karthikpp03/ai-desk-animation-cloud/firmware/AIDeskCompanion/MotionAnimations.h

#pragma once
#include <Arduino.h>

// Compressed 128x64 OLED motion animations generated from the supplied reference sketches.
// Each frame is byte-RLE encoded as [runLength, byteValue] pairs.
// The source frame data is preserved; compression keeps flash use low enough for ESP32 firmware.

static const uint16_t IDIOT_FRAME_COUNT = 50;
static const uint16_t IDIOT_FRAME_OFFSETS[51] PROGMEM = {
  0, 10, 48, 94, 136, 200, 266, 332, 398, 464, 530, 596,
  662, 728, 794, 860, 902, 946, 1004, 1066, 1152, 1234, 1350, 1462,
  1588, 1710, 1878, 2038, 2202, 2386, 2566, 2764, 2952, 3140, 3328, 3516,
  3704, 3892, 4080, 4268, 4456, 4644, 4832, 5020, 5208, 5396, 5584, 5772,
  5960, 6148, 6336
};
static const uint8_t IDIOT_RLE_DATA[6336] PROGMEM = {
  0xFF, 0x00, 0xFF, 0x00, 0xFF, 0x00, 0xFF, 0x00, 0x04, 0x00, 0xFF, 0x00, 0xC8, 0x00, 0x01, 0x03, 0x01, 0x80, 0x0E, 0x00, 0x01, 0x01, 0x0F, 0x00,
  0x01, 0x01, 0x0F, 0x00, 0x01, 0x01, 0x0F, 0x00, 0x01, 0x01, 0x0F, 0x00, 0x01, 0x01, 0x0F, 0x00, 0x01, 0x03, 0x01, 0x80, 0xFF, 0x00, 0xD8, 0x00,
  0xFF, 0x00, 0xC8, 0x00, 0x01, 0x1C, 0x01, 0x08, 0x0E, 0x00, 0x02, 0x08, 0x0E, 0x00, 0x01, 0x08, 0x01, 0x68, 0x0E, 0x00, 0x01, 0x08, 0x01, 0x98,
  0x0E, 0x00, 0x01, 0x08, 0x01, 0x88, 0x0E, 0x00, 0x01, 0x08, 0x01, 0x88, 0x0E, 0x00, 0x01, 0x1C, 0x01, 0x78, 0xFF, 0x00, 0xD8, 0x00, 0xFF, 0x00,
  0xC8, 0x00, 0x01, 0xE0, 0x01, 0x44, 0x0E, 0x00, 0x02, 0x40, 0x0E, 0x00, 0x01, 0x43, 0x01, 0x4C, 0x0E, 0x00, 0x01, 0x44, 0x01, 0xC4, 0x0E, 0x00,
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
  0x01, 0x20, 0x0A, 0x00, 0x01, 0x40, 0x01, 0x00, 0x01, 0x04, 0x02, 0x00, 0x01, 0x40, 0x0C, 0x00, 0x01, 0x04, 0x06, 0x00, 0x01, 0x04, 0x0F, 0x00,
  0x01, 0x03, 0x10, 0x00, 0x01, 0xC0, 0x68, 0x00, 0x01, 0x40, 0x0C, 0x00, 0x01, 0x04, 0x01, 0x00, 0x01, 0x01, 0x01, 0x80, 0x0C, 0x00, 0x01, 0x04,
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
};
