karthikpp03/ai-desk-animation-cloud/(commit log)

2026-10-04 Update device command state
2026-10-04 Add animation frames: alone
2026-10-04 Update device heartbeat
2026-10-04 Add animation frames: anime
2026-10-04 Request device mode change
2026-10-04 Add animation frames: alone2
2026-10-04 Add animation frames: back_hug
2026-10-04 Add animation frames: cat
2026-10-04 Add animation frames: cat_tap
2026-10-04 Add animation metadata: coupled
2026-10-04 Add animation frames: coupled
2026-10-04 Add animation frames: hand_hold
2026-10-04 Add animation frames: hug
2026-10-04 Add animation frames: love
2026-10-04 Add animation frames: music
2026-10-04 Add animation frames: oled_display
2026-10-04 Add animation frames: oled_display_1
2026-10-04 Add animation frames: ouple_luv
2026-10-04 Add animation frames: lala
2026-10-04 Add animation frames: smile
2026-10-04 Add animation frames: face
2026-10-04 bug fix and animation
    [Animation.cpp, Animation.h, Config.h, MotionAnimations.h, MotionManager.cpp, MotionManager.h, ScreenManager.cpp]
2026-10-04 Add animation frames: coffe
2026-10-04 Add animation frames: idiot
2026-10-04 Add animation frames: stupid
2026-10-04 Add animation frames: dizzyyy
2026-10-04 Add animation frames: boy
2026-10-06 commands updated and wifi fix
    [DrawPadManager.cpp, WiFiManager.cpp, WiFiManager.h]
